liji3597/CACRS-on-STM32F4/planoverview/2.png

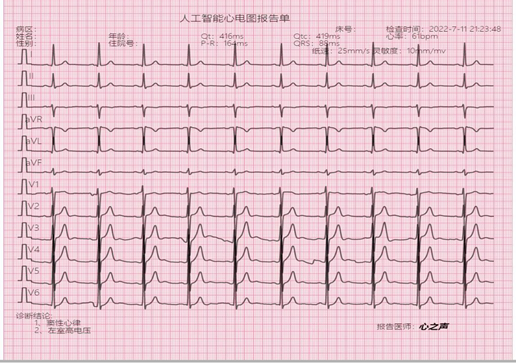
planoverview/2.png
