liji3597/CACRS-on-STM32F4/429/1.0/Core/取模方式.png

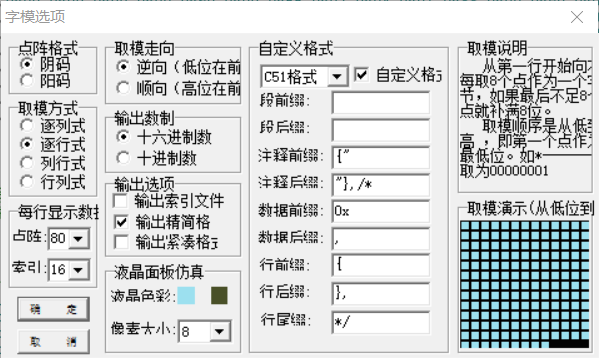
429/1.0/Core/取模方式.png
