liji3597/CACRS-on-STM32F4/planoverview/1.png

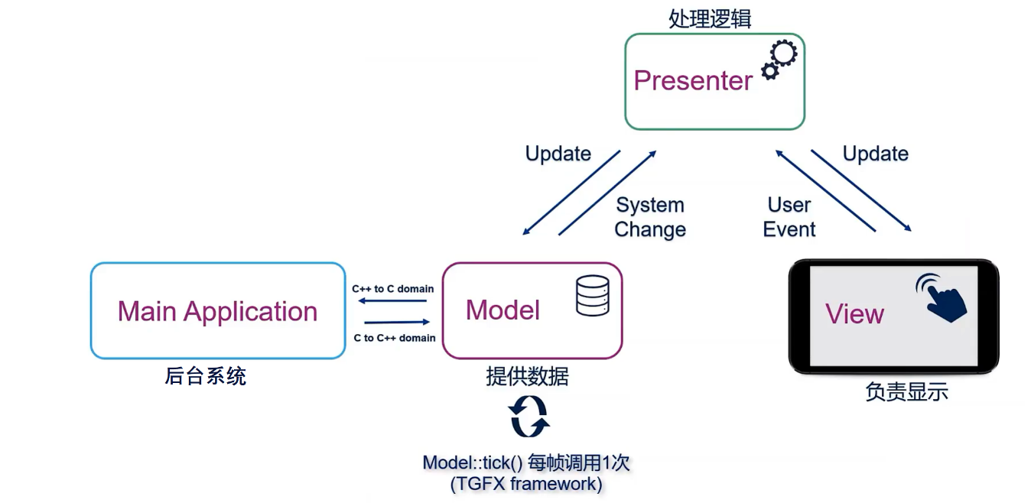
planoverview/1.png
