liji3597/CACRS-on-STM32F4/429/1.0/Core/Inc/main.h

#define KEY0_Pin GPIO_PIN_8
#define KEY0_GPIO_Port GPIOI
#define KEY0_EXTI_IRQn EXTI9_5_IRQn
#define AD1292_DRDY_Pin GPIO_PIN_0
#define AD1292_DRDY_GPIO_Port GPIOA
#define AD1292_DRDY_EXTI_IRQn EXTI0_IRQn
#define AD1292_CS_Pin GPIO_PIN_1
#define AD1292_CS_GPIO_Port GPIOA
#define AD1292_ST_Pin GPIO_PIN_2
#define AD1292_ST_GPIO_Port GPIOH
#define AD1292_PW_Pin GPIO_PIN_3
#define AD1292_PW_GPIO_Port GPIOH
#define LTDC_Black_Pin GPIO_PIN_13
#define LTDC_Black_GPIO_Port GPIOD
#define LED1_Pin GPIO_PIN_3
#define LED1_GPIO_Port GPIOI
#define LED0_Pin GPIO_PIN_4
#define LED0_GPIO_Port GPIOD
#define IIC_CL_Pin GPIO_PIN_4
#define IIC_CL_GPIO_Port GPIOB
#define IIC_DA_Pin GPIO_PIN_6
#define IIC_DA_GPIO_Port GPIOB
