liji3597/CACRS-on-STM32F4/429/1.0/Core/Src/lcd_fonts.c

/**
  ******************************************************************************
  *	@file  	 	lcd_fonts.c
  *	@version 	V1.0
  * @date    	2021-06-01
  *	@author  	知行科技
  *	@brief   	字模数据，可自行添加或删减
  ******************************************************************************
  * @attention
  *
  *	实验平台：STM32核心板M2 
  *
>>>>> 文件说明：
  *
  *	1.ASCII字符集: !"#$%&'()*+,-./0123456789:;<=>?@ABCDEFGHIJKLMNOPQRSTUVWXYZ[\]^_`abcdefghijklmnopqrstuvwxyz{|}~
  *	2.ASCII字模，总共有5种大小的字模：3216、2412、2010、1608、1206，皆是宋体
  *	3.中文字模也有五种大小：3232、2424、2020、1616、1212
  *	4.中文字库是小字库，也就是用到了相应的汉字再取模
  *	5.中文字库每个字模后面都必须要有一个对应的汉字作为索引
  *
>>>>> 取模方式说明：
  *
  *	1.取模软件 PCtolCD2018
  *	2.阴码、逆向、逐行式、C51格式、像素大小8、注释前段【{"】、注释后段【"},/8*】。
  *
  ******************************************************************************
  */

#include "lcd_fonts.h"

// 汉字字模数据，字体为1212
// 添加新字模时，一定要不超过数组第一维的大小，用户可根据需求自行调整
//	中文标点符号和英文标点符号是不一样的！如果没有对中文标点符号进行取模，显示时要用英文输入标点，使用ASCII的字模
// 每个字模后面都必须要有一个对应的汉字作为索引
//
const uint8_t  Chinese_1212[20][24]=	
{ 
//	 中(0) 文(1) 字(2) 体(3) ：(4) 知(5) 行(6) 科(7) 技(8)
	{0x20,0x00,0x20,0x00,0x20,0x00,0xFE,0x03,0x22,0x02,0x22,0x02,0x22,0x02,0xFE,0x03,0x22,0x02,0x20,0x00,0x20,0x00,0x20,0x00},{"中"},/*0*/
	{0x10,0x00,0x20,0x00,0xFF,0x07,0x04,0x01,0x04,0x01,0x88,0x00,0x88,0x00,0x50,0x00,0x20,0x00,0x50,0x00,0x8C,0x01,0x03,0x06},{"文"},/*1*/
	{0x10,0x00,0x20,0x00,0xFF,0x07,0x01,0x04,0x00,0x00,0xFC,0x01,0x80,0x00,0x40,0x00,0xFF,0x07,0x20,0x00,0x20,0x00,0x38,0x00},{"字"},/*2*/
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
	48,                  //	单个字符的字模数据个数
	0                    // 该参数只有汉字字模用到，表示二维数组的行大小
};

pFONT Font20 = {
	ASCII_2010_Table,		//	字模数组地址
	10,                  //	单个字符的字模宽度
	20,                  //	单个字符的字模长度
	40,                  //	单个字符的字模数据个数
	0                    // 该参数只有汉字字模用到，表示二维数组的行大小
};

pFONT Font16 = {
	ASCII_1608_Table,		//	字模数组地址
	8,                   //	单个字符的字模宽度
	16,                  //	单个字符的字模长度
	16,                  //	单个字符的字模数据个数
	0                    // 该参数只有汉字字模用到，表示二维数组的行大小
};

pFONT Font12 = {
	ASCII_1206_Table,		//	字模数组地址
	6,                   //	单个字符的字模宽度
	12,                  //	单个字符的字模长度
	12,                  //	单个字符的字模数据个数
	0                    // 该参数只有汉字字模用到，表示二维数组的行大小
};
