liji3597/CACRS-on-STM32F4/429/1.0/Core/Src/ecg_fir.c

#include "ecg_fir.h"
#include "callback.h"
#include "math.h"
#include "sys.h"

#define ECG_DATE_SIZE  			 1    	/* 采样点数 */
#define BLOCK_SIZE           1    	/* 调用一次arm_fir_f32处理的采样点个数 */
#define NUM_TAPS             129    /* 滤波器系数个数 */


uint32_t blockSize = BLOCK_SIZE;
uint32_t numBlocks = ECG_DATE_SIZE/BLOCK_SIZE;            /* 需要调用arm_fir_f32的次数 */
 
//static float32_t testInput_f32_50Hz_200Hz[ECG_DATE_SIZE]; /* 采样点 */
//static float32_t testOutput[ECG_DATE_SIZE];               /* 滤波后的输出 */

static float32_t firStateF32[BLOCK_SIZE + NUM_TAPS - 1];        /* 状态缓存，大小numTaps + blockSize - 1*/

arm_fir_instance_f32 S;

/* 带通滤波器系数 通过fadtool获取*/
const float32_t firCoeffs32BP[NUM_TAPS] = {
  3.523997657e-05,0.0002562592272,0.0005757701583,0.0008397826459, 0.000908970891,
  0.0007304374012,0.0003793779761,4.222582356e-05,-6.521392788e-05,0.0001839015895,
  0.0007320778677, 0.001328663086, 0.001635892317, 0.001413777587,0.0006883906899,
  -0.0002056905651,-0.0007648666506,-0.0005919140531,0.0003351111372, 0.001569915912,
   0.002375603188, 0.002117323689,0.0006689901347,-0.001414557919,-0.003109993879,
  -0.003462586319, -0.00217742566,8.629632794e-05, 0.001947802957, 0.002011778764,
  -0.0002987752669,-0.004264956806, -0.00809297245,-0.009811084718,-0.008411717601,
  -0.004596390296,-0.0006214127061,0.0007985962438,-0.001978532877,-0.008395017125,
   -0.01568987407, -0.02018531598, -0.01929843985, -0.01321159769,-0.005181713495,
  -0.0001112028476,-0.001950757345, -0.01125541423,  -0.0243169684, -0.03460548073,
   -0.03605531529, -0.02662901953, -0.01020727865, 0.004513713531, 0.008002913557,
  -0.004921500571, -0.03125274926, -0.05950148031, -0.07363011688, -0.05986980721,
   -0.01351031102,  0.05752891302,   0.1343045086,   0.1933406889,   0.2154731899,
     0.1933406889,   0.1343045086,  0.05752891302, -0.01351031102, -0.05986980721,
   -0.07363011688, -0.05950148031, -0.03125274926,-0.004921500571, 0.008002913557,
   0.004513713531, -0.01020727865, -0.02662901953, -0.03605531529, -0.03460548073,
    -0.0243169684, -0.01125541423,-0.001950757345,-0.0001112028476,-0.005181713495,
   -0.01321159769, -0.01929843985, -0.02018531598, -0.01568987407,-0.008395017125,
  -0.001978532877,0.0007985962438,-0.0006214127061,-0.004596390296,-0.008411717601,
  -0.009811084718, -0.00809297245,-0.004264956806,-0.0002987752669, 0.002011778764,
   0.001947802957,8.629632794e-05, -0.00217742566,-0.003462586319,-0.003109993879,
  -0.001414557919,0.0006689901347, 0.002117323689, 0.002375603188, 0.001569915912,
  0.0003351111372,-0.0005919140531,-0.0007648666506,-0.0002056905651,0.0006883906899,
   0.001413777587, 0.001635892317, 0.001328663086,0.0007320778677,0.0001839015895,
  -6.521392788e-05,4.222582356e-05,0.0003793779761,0.0007304374012, 0.000908970891,
  0.0008397826459,0.0005757701583,0.0002562592272,3.523997657e-05
};
	/* 初始化结构体S */
void arm_fir_init(void)
{
	arm_fir_init_f32(&S, NUM_TAPS, (float32_t *)&firCoeffs32BP[0], &firStateF32[0], blockSize);
}

void arm_fir(float32_t *inputF32, float32_t *outputF32)
{
uint32_t i;
//float32_t  *inputF32, *outputF32;
 
/* 初始化输入输出缓存指针 */
//inputF32 = &testInput_f32_50Hz_200Hz[0];
//outputF32 = &testOutput[0];
// 


/* 实现FIR滤波 */
	for(i=0; i < numBlocks; i++)
	{
		arm_fir_f32(&S, inputF32 + (i * blockSize), outputF32 + (i * blockSize), blockSize);
	}
 
/* 打印滤波后结果 */
//	for(i=0; i<ECG_DATE_SIZE; i++)
//	{
//		printf("%f\r\n", testOutput[i]);
//	}
}
