liji3597/CACRS-on-STM32F4/429/1.0/Core/Inc/dht11.h

#ifndef __DHT11_H
#define __DHT11_H 
#include "sys.h"   

 
//IO方向设置
#define DHT11_IO_IN()  {GPIOC->MODER&=~(3<<(11*2));GPIOC->MODER|=0<<(11*2);}	//PB12输入模式
#define DHT11_IO_OUT() {GPIOC->MODER&=~(3<<(11*2));GPIOC->MODER|=1<<(11*2);} 	//PB12输出模式
 
////IO操作函数											   
#define	DHT11_DQ_OUT PCout(11) //数据端口	PC11
#define	DHT11_DQ_IN  PCin(11)  //数据端口	PC11


u8 DHT11_Init(void);//初始化DHT11
u8 DHT11_Read_Data(u8 *temp,u8 *humi);//读取温湿度
u8 DHT11_Read_Byte(void);//读出一个字节
u8 DHT11_Read_Bit(void);//读出一个位
u8 DHT11_Check(void);//检测是否存在DHT11
void DHT11_Rst(void);//复位DHT11    
#endif
