liji3597/CACRS-on-STM32F4/429/1.0/Core/Src/delay.c

/**
  ******************************************************************************
  *	@file  	 	delay.c
  *	@version 	V1.0
  * @date    	2021-06-01
  *	@author  	知行科技
  *	@brief   	使用SysTick的普通计数模式对延迟进行管理
  ******************************************************************************
  * @attention
  *
  * <h2><center>&copy; Copyright (c) 2021 STMicroelectronics.
  * All rights reserved.</center></h2>
  *
  * This software component is licensed by ST under BSD 3-Clause license,
  * the "License"; You may not use this file except in compliance with the
  * License. You may obtain a copy of the License at:
  *                        opensource.org/licenses/BSD-3-Clause
  *
  ******************************************************************************
  */

/* Includes ------------------------------------------------------------------*/
#include "delay.h"
#include "sys.h"

/* Private variables ---------------------------------------------------------*/
/*us延时倍乘数*/
static u32 fac_us=0;

/* Private user code ---------------------------------------------------------*/

//初始化延迟函数
//当使用ucos的时候,此函数会初始化ucos的时钟节拍
//SYSTICK的时钟固定为AHB时钟
//SYSCLK:系统时钟频率
void delay_init(u8 SYSCLK)
{
    HAL_SYSTICK_CLKSourceConfig(SYSTICK_CLKSOURCE_HCLK);//SysTick频率为HCLK
	fac_us=SYSCLK;						//不论是否使用OS,fac_us都需要使用
}								    

//延时nus
//nus为要延时的us数.	
//nus:0~190887435(最大值即2^32/fac_us@fac_us=22.5)	 
void delay_us(u32 nus)
{		
	u32 ticks;
	u32 told,tnow,tcnt=0;
	u32 reload=SysTick->LOAD;				//LOAD的值	    	 
	ticks=nus*fac_us; 						//需要的节拍数 
	told=SysTick->VAL;        				//刚进入时的计数器值
	while(1)
	{
		tnow=SysTick->VAL;	
		if(tnow!=told)
		{	    
			if(tnow<told)tcnt+=told-tnow;	//这里注意一下SYSTICK是一个递减的计数器就可以了.
			else tcnt+=reload-tnow+told;	    
			told=tnow;
			if(tcnt>=ticks)break;			//时间超过/等于要延迟的时间,则退出.
		}  
	};
}

//延时nms
//nms:要延时的ms数
void delay_ms(u16 nms)
{
	u32 i;
	for(i=0;i<nms;i++) delay_us(1000);
}
			 
