liji3597/CACRS-on-STM32F4/407/UI1/Core/Src/DHT11/bsp_dht11.c

/**
  ******************************************************************************
  * @file    bsp_dht11.c
  * @author  fire
  * @version V1.0
  * @date    2015-xx-xx
  * @brief   温湿度传感器应用函数接口
  ******************************************************************************
  * @attention
  *
  * 实验平台:野火  STM32 F407 开发板  
  * 论坛    :http://www.firebbs.cn
  * 淘宝    :https://fire-stm32.taobao.com
  *
  ******************************************************************************
  */
#include "bsp_dht11.h"
#include "delay.h" 

/* 可以在下面的宏定义中把后面的延时函数替换换SysTick的延时函数，就是想用那个就换成那个的 */


/*
 * 函数名：DHT11_GPIO_Config
 * 描述  ：配置DHT11用到的I/O口
 * 输入  ：无
 * 输出  ：无
 */
void DHT11_GPIO_Config(void)
{		
	/*定义一个GPIO_InitTypeDef类型的结构体*/
	GPIO_InitTypeDef GPIO_InitStructure;

	/*开启DHT11_PORT的外设时钟*/
	__HAL_RCC_GPIOE_CLK_ENABLE(); 

	/*选择要控制的DHT11_PORT引脚*/															   
  	GPIO_InitStructure.Pin = DHT11_PIN;	

	/*设置引脚模式为通用推挽输出*/
  	GPIO_InitStructure.Mode = GPIO_MODE_OUTPUT_PP;   
  
  /*设置引脚的输出类型为推挽输出*/
//  GPIO_InitStructure.Type = GPIO_OType_PP;
  
  /*设置引脚为上拉模式*/
	GPIO_InitStructure.Pull = GPIO_PULLUP;
  
	/*设置引脚速率为50MHz */   
  GPIO_InitStructure.Speed = GPIO_SPEED_FREQ_HIGH; 

	/*调用库函数，初始化DHT11_PORT*/
  HAL_GPIO_Init(DHT11_PORT, &GPIO_InitStructure); 
}

/*
 * 函数名：DHT11_Mode_IPU
 * 描述  ：使DHT11-DATA引脚变为上拉输入模式
 * 输入  ：无
 * 输出  ：无
 */
static void DHT11_Mode_IPU(void)
{
 	  GPIO_InitTypeDef GPIO_InitStructure;

	  	/*选择要控制的DHT11_PORT引脚*/	
	  GPIO_InitStructure.Pin = DHT11_PIN;

	   /*设置引脚模式为浮空输入模式*/ 
	  GPIO_InitStructure.Mode = GPIO_MODE_INPUT ; 
  
	  GPIO_InitStructure.Pull = GPIO_NOPULL;
  
  	/*设置引脚速率为50MHz */   
    GPIO_InitStructure.Speed = GPIO_SPEED_FREQ_HIGH; 
  
	  /*调用库函数，初始化DHT11_PORT*/
	  HAL_GPIO_Init(DHT11_PORT, &GPIO_InitStructure);	 
}

/*
 * 函数名：DHT11_Mode_Out_PP
 * 描述  ：使DHT11-DATA引脚变为推挽输出模式
 * 输入  ：无
 * 输出  ：无
 */
static void DHT11_Mode_Out_PP(void)
{
 	GPIO_InitTypeDef GPIO_InitStructure;

	/*选择要控制的DHT11_PORT引脚*/															   
  GPIO_InitStructure.Pin = DHT11_PIN;	

	/*设置引脚模式为通用推挽输出*/
  	GPIO_InitStructure.Mode = GPIO_MODE_OUTPUT_PP;   
  
  /*设置引脚的输出类型为推挽输出*/
//  GPIO_InitStructure.GPIO_OType = GPIO_OType_PP;
  
  /*设置引脚为上拉模式*/
	GPIO_InitStructure.Pull = GPIO_PULLUP;
  
	/*设置引脚速率为50MHz */   
  GPIO_InitStructure.Speed = GPIO_SPEED_FREQ_HIGH; 

	/*调用库函数，初始化DHT11_PORT*/
  	HAL_GPIO_Init(DHT11_PORT, &GPIO_InitStructure);	 	 
}

/* 
 * 从DHT11读取一个字节，MSB先行
 */
static uint8_t Read_Byte(void)
{
	uint8_t i, temp=0;

	for(i=0;i<8;i++)    
	{	 
		/*每bit以50us低电平标置开始，轮询直到从机发出 的50us 低电平 结束*/  
		while(DHT11_DATA_IN()==GPIO_PIN_RESET);

		/*DHT11 以26~28us的高电平表示“0”，以70us高电平表示“1”，
		 *通过检测 x us后的电平即可区别这两个状 ，x 即下面的延时 
		 */
		delay_us(40); //延时x us 这个延时需要大于数据0持续的时间即可	   	  

		if(DHT11_DATA_IN()==GPIO_PIN_SET)/* x us后仍为高电平表示数据“1” */
		{
			/* 等待数据1的高电平结束 */
			while(DHT11_DATA_IN()==GPIO_PIN_SET);

			temp|=(uint8_t)(0x01<<(7-i));  //把第7-i位置1，MSB先行 
		}
		else	 // x us后为低电平表示数据“0”
		{			   
			temp&=(uint8_t)~(0x01<<(7-i)); //把第7-i位置0，MSB先行
		}
	}
	return temp;
}
/*
 * 一次完整的数据传输为40bit，高位先出
 * 8bit 湿度整数 + 8bit 湿度小数 + 8bit 温度整数 + 8bit 温度小数 + 8bit 校验和 
 */
uint8_t Read_DHT11(DHT11_Data_TypeDef *DHT11_Data)
{  
  uint16_t count;
	/*输出模式*/
	DHT11_Mode_Out_PP();
	/*主机拉低*/
	DHT11_DATA_OUT(DHT11_LOW);
	/*延时18ms*/
	delay_us(20000);

	/*总线拉高 主机延时30us*/
	DHT11_DATA_OUT(DHT11_HIGH); 

	delay_us(30);   //延时30us

	/*主机设为输入 判断从机响应信号*/ 
	DHT11_Mode_IPU();

	/*判断从机是否有低电平响应信号 如不响应则跳出，响应则向下运行*/   
	if(DHT11_DATA_IN()==GPIO_PIN_RESET)     
	{
    count=0;
		/*轮询直到从机发出 的80us 低电平 响应信号结束*/  
		while(DHT11_DATA_IN()==GPIO_PIN_RESET)
    {
      count++;
      if(count>1000)  return 0;
      delay_us(10); 
    }    
    
    count=0;
		/*轮询直到从机发出的 80us 高电平 标置信号结束*/
		while(DHT11_DATA_IN()==GPIO_PIN_SET)
    {
      count++;
      if(count>1000)  return 0;
      delay_us(10); 
    }  
		/*开始接收数据*/   
		DHT11_Data->humi_int= Read_Byte();

		DHT11_Data->humi_deci= Read_Byte();

		DHT11_Data->temp_int= Read_Byte();

		DHT11_Data->temp_deci= Read_Byte();

		DHT11_Data->check_sum= Read_Byte();

		/*读取结束，引脚改为输出模式*/
		DHT11_Mode_Out_PP();
		/*主机拉高*/
		DHT11_DATA_OUT(DHT11_HIGH);

		/*检查读取的数据是否正确*/
		if(DHT11_Data->check_sum == DHT11_Data->humi_int + DHT11_Data->humi_deci + DHT11_Data->temp_int+ DHT11_Data->temp_deci)
			return 1;
		else 
			return 0;
	}
	else
	{		
		return 0;
	}   
}
