liji3597/CACRS-on-STM32F4/(notices)

Notices in the files:
429/1.0/Core/Inc/main.h:
(C) COPYRIGHT STMicroelectronics *****END OF FILE
429/1.0/Core/mpu/mpu6050.h:
Copyright(C) ¹ãÖÝÊÐÐÇÒíµç×Ó¿Æ¼¼ÓÐÏÞ¹«Ë¾ 2014-2024
All rights reserved
